Izza-Gul/Wearable-Robotic-Trainer-with-AI-Based-Adaptive-Motivation-for-Pediatric-Gait-Rehabilitation/System-Architecture.png

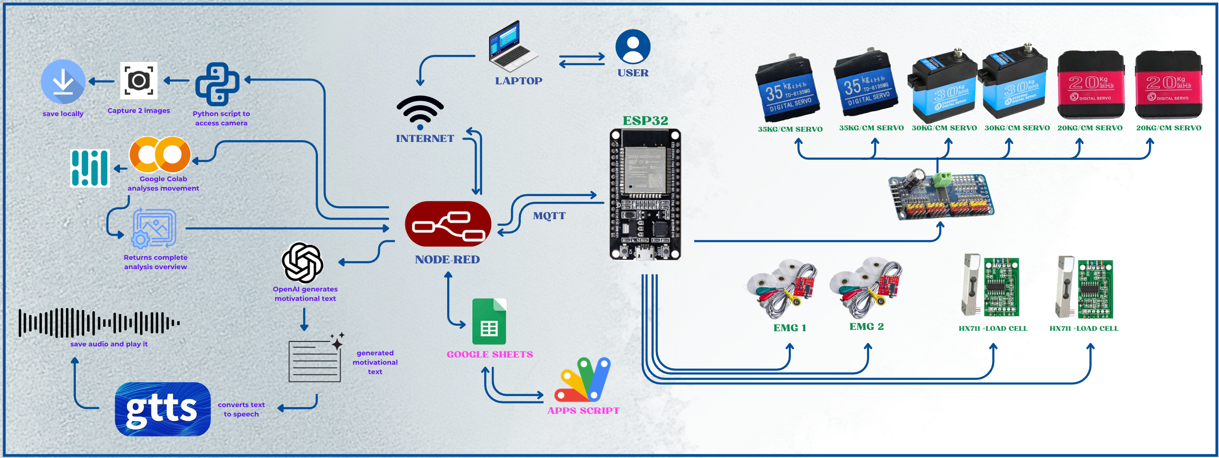
System-Architecture.png
