Izza-Gul/Wearable-Robotic-Trainer-with-AI-Based-Adaptive-Motivation-for-Pediatric-Gait-Rehabilitation/README.md

##Wearable-Robotic-Trainer-with-AI-Based-Adaptive-Motivation-for-Pediatric-Gait-Rehabilitation
**Bachelor of Electrical Engineering – My Final Year Design Project**  

---

## 📌 Project Overview
This project develops a wearable robotic trainer to assist pediatric patients in lower-limb gait recovery.  
The system integrates:
- **Motorized movement assistance**
- **AI-generated adaptive motivation** (visual & audio)
- **Sensors for movement detection and feedback**

---

## 📂 Project Files

###  Components
[📄 View PDF](Components.pdf)  
A detailed list of all components used in the project.

###  Connection
[🖼 View Diagram](connection.pdf)  
Illustrates how all components are connected.

### 🎬 ICF-CY Disability Selection & Exercise
- [🎥 Watch Video ](disability-selection.mp4)  

### 📷 Device Sketch  
🖼 [View Image](device-sketch.png)  
An early conceptual sketch of the wearable robotic device design.

### 📄 Proposal  
📘 [View Proposal](proposal.pdf)  
Includes detailed system architecture, objectives, and implementation plan.

### 🎬 Project Overview Video  
🎞 [Watch Video](project-overview.mp4)  
A complete overview video explaining the concept, design, and functionality of the system.

### 🎬 Project Defense Presentation Slides   
🎞 [View on Canva](https://www.canva.com/design/DAGwwStF2fg/c1ddKkLbOcMcR_Od0FajzA/view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) 

-----------------------------------------------------------------------------------------------

UPDATE 19/1/2026

### 🔹 Hardware & Software Progress Presentation
[View on Canva](https://www.canva.com/design/DAGwwStF2fg/c1ddKkLbOcMcR_Od0FajzA/view)

### 🔹 Complete System Architecture
🖼 [View Image](System-Architecture.png) 

----------------------------------------------------------------------------------------------

##  FINAL UPDATE — 19/01/2026

Following the successful completion of the project, the repository has been updated with the final implementation, source code, testing materials, and supporting documentation.

### 📘 Final Thesis

📄 [View Thesis](FYDP_Thesis.pdf)

The complete graduation thesis including methodology, implementation details, validation procedures, and final results.

### 📊 Node-RED Dashboard

📄 [Open Node-RED Flow](flows.json)

Complete therapist dashboard implementation including monitoring, control, and session logging functionalities.

### 🧠 AI Motivational System

The final AI motivational pipeline source code:

* `capture_two_images.py`
* `analyze_images.py`
* `visual_generator.py`

### 🤖 Embedded Control System

Source code for the wearable robotic trainer control system:

* `Robot.ino`

### 🏗 Final System Architecture

🖼 [View System Architecture](System-Architecture.png)

Final integrated hardware and software architecture of the complete rehabilitation system.

### 📈 Final Progress Presentation

🎞 [View on Canva](https://canva.link/fcr3cyjkh7j1uhy)

Final hardware and software implementation progress presentation.

### 🧪 Testing & Validation Results

🎞 [View on Canva](https://canva.link/punf2cz9vm863uq)

Includes system validation procedures, performance evaluation, and experimental testing results.

---

*This repository now contains the final version of the project after successful completion and evaluation.*
